MrCybernetic/MoistureSensorV2/README.md

# MoistureSensorV2

## Introduction
Moisture sensor sending values (battery voltage, moisture and temperature values) over MQTT. The MQTT are managed by Nodered to format and send via FTP to a [website](http://cybergarden.xyz/chart.html) to display them. The moisture soil sensor can be found with "Moisture Soil V1.2" keywords on internet. It's a capacitive sensor I prefer compare to resistive sensor (not reliable, corrosion).

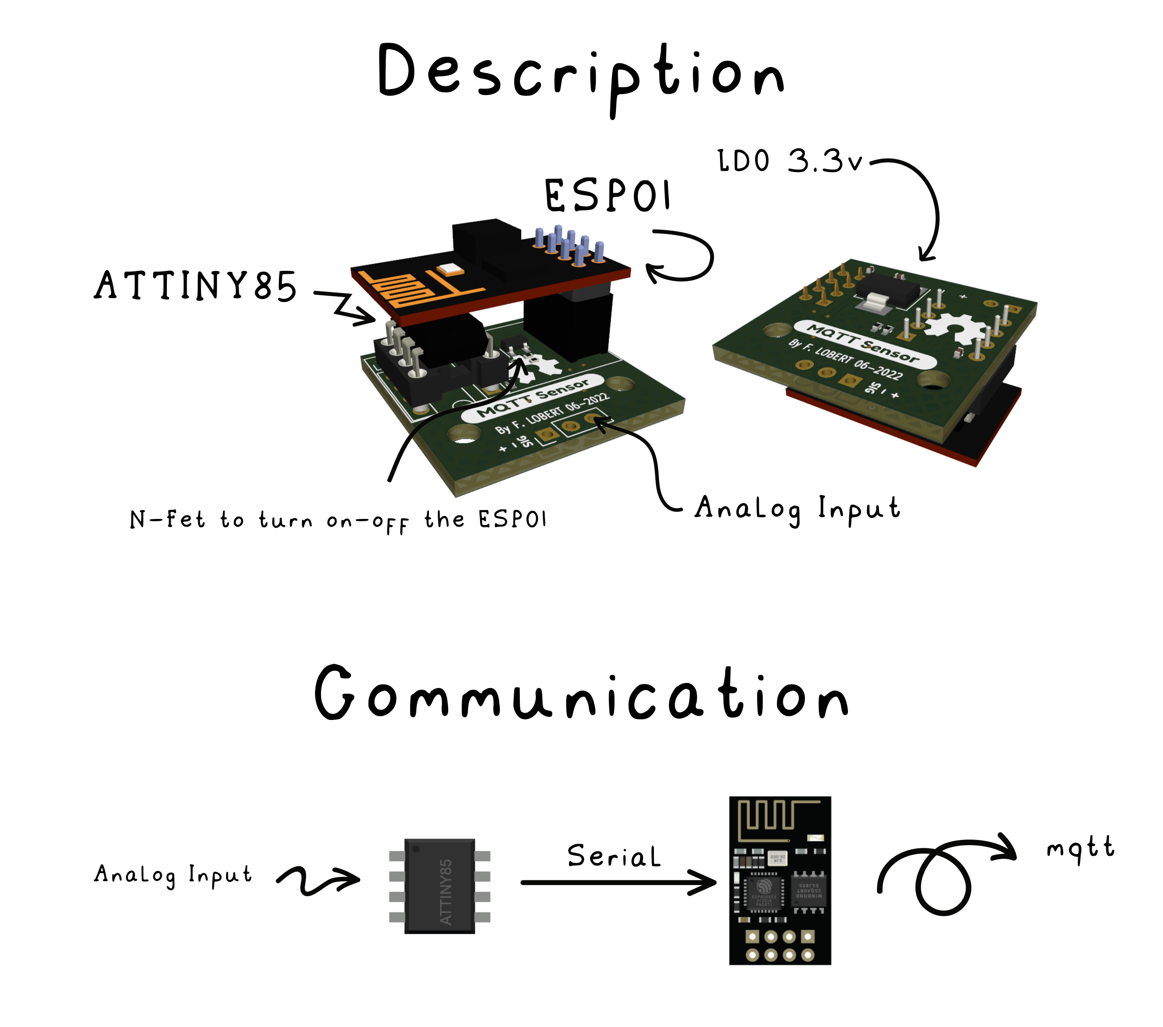
[picture p1: img/explanation.png]


## Status

 - Electronics ✅
 - CAD ✅
 - Developpment ✅
 - Tests ✅

## Challenges
- MQTT
- Power Consumption
- Data visualisation
- Components Shortage
- Outdoor stuff -> Waterproof
- Hobby stuff: 3D print, hand soldering

## CAO :
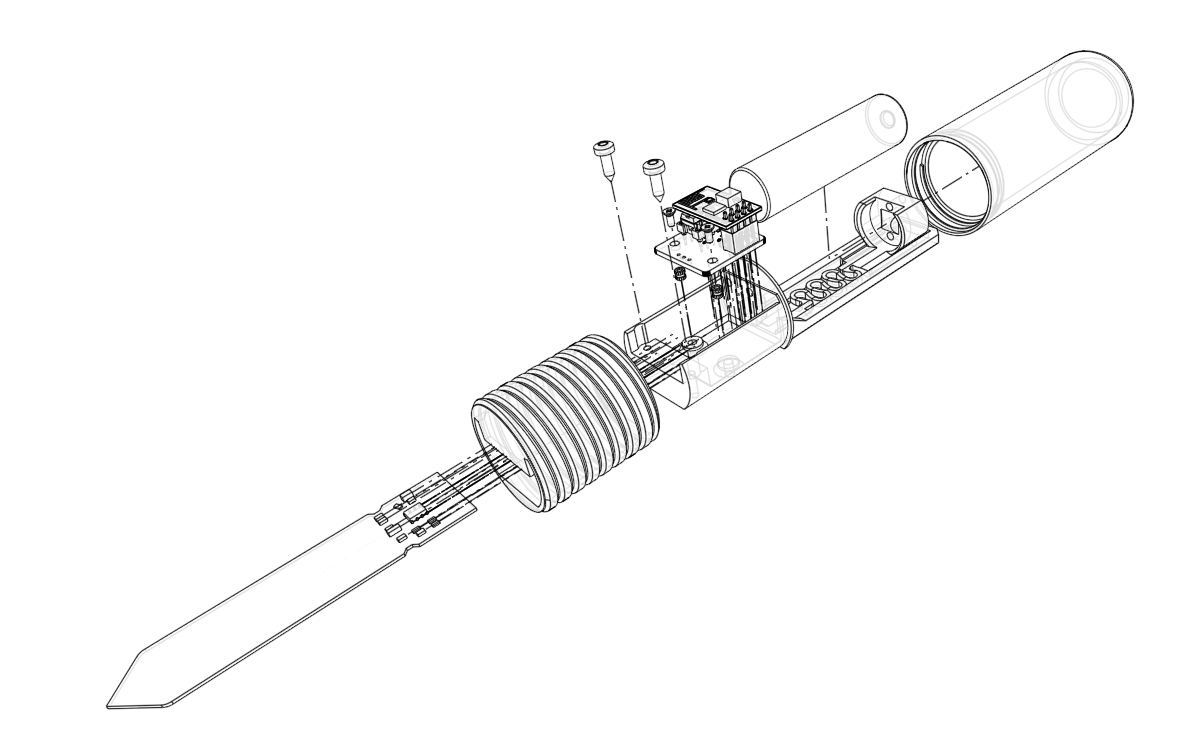
[picture p2: img/CAO.png]
