MrCybernetic/MoistureSensorV2/3Ds/OnShape_Link.txt

https://cad.onshape.com/documents/f10877bfe9b4fd1742ca4c39/w/fbb57eb4642451b069fcb2c7/e/eff2d412964ae911dceb8f07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
