MrCybernetic/MoistureSensorV2/img/IMG_2979.jpg

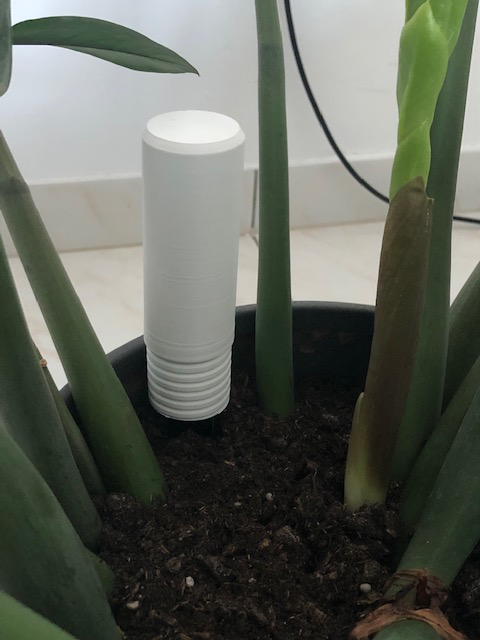
img/IMG_2979.jpg
