MrCybernetic/MoistureSensorV2/Electronics/circuit_diagram_MoistureSensorV2.pdf

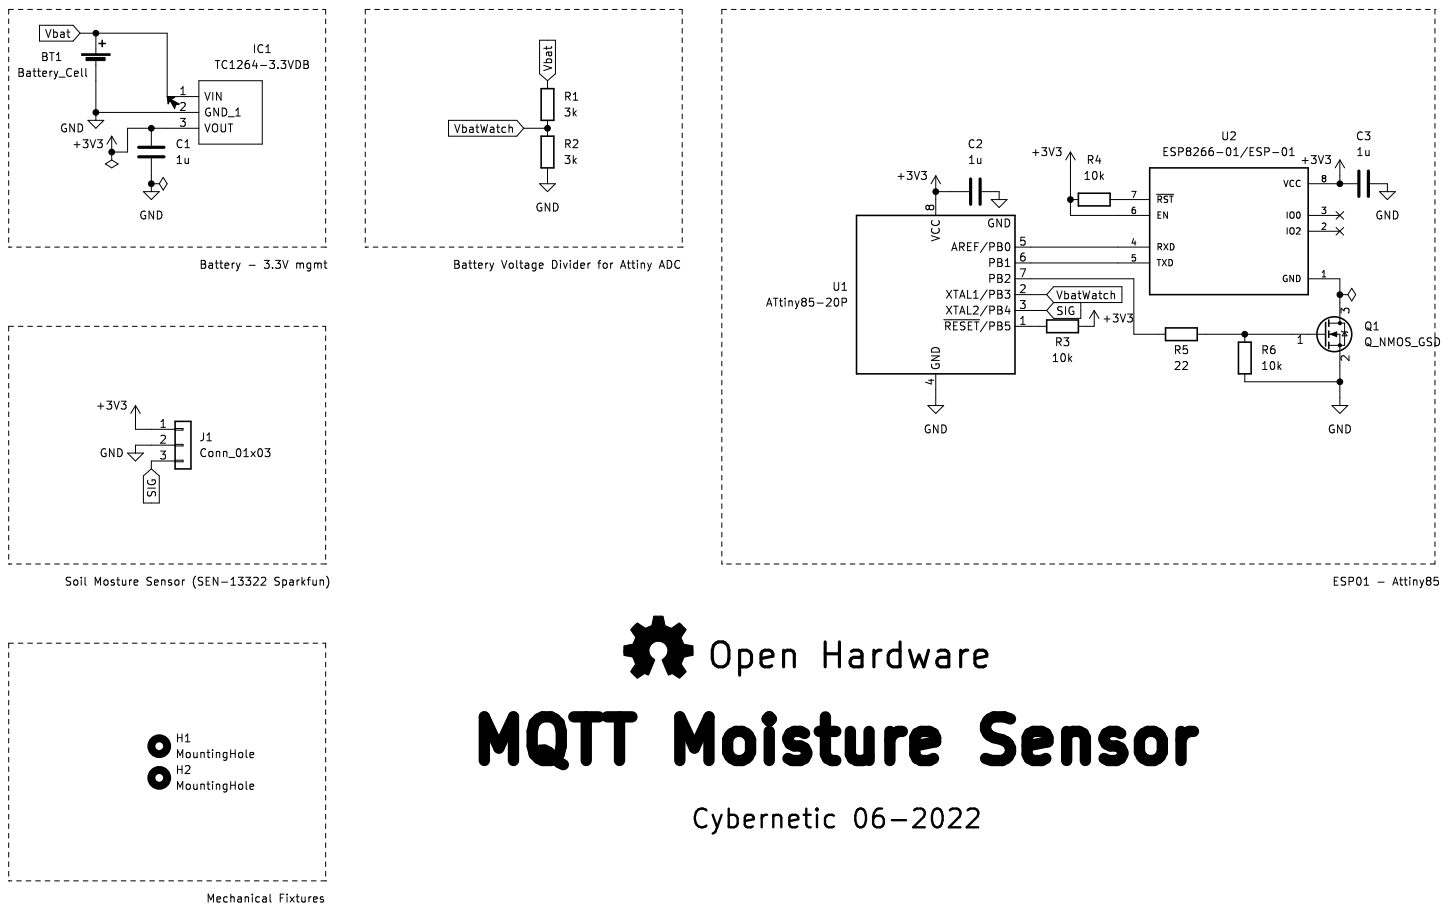
[picture p4: page 1]
