MrCybernetic/MoistureSensorV2/img/Attiny85_tuning_breadboard.png

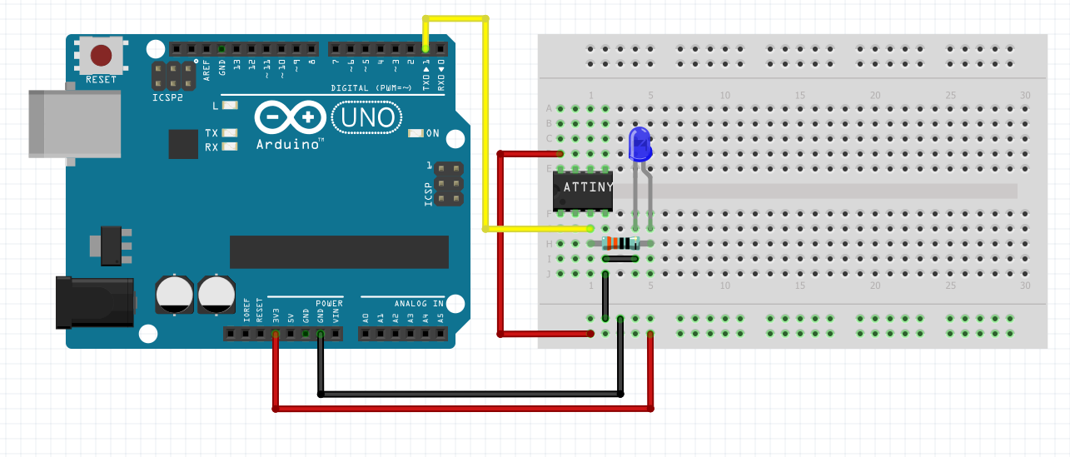
img/Attiny85_tuning_breadboard.png
