MrCybernetic/MoistureSensorV2/(commit log)

2022-06-26 string to char length fix
    [MoistureMQTT_ESP.ino]
2022-06-26 Header to define what the arduino sketch does
2022-06-26 Voltage for Attiny ADC error. Add voltage divider
2022-06-26 Correction in schematics and progress on arduinos
    [Attiny85Tuning.ino, MoistureMQTT_Attiny.ino]
2022-06-26 bom updated
2022-07-29 create sketch to test sensor
2022-08-03 Temperature integration (#2)
    * Modify code to run tests quickly
    * create sketch to test sensor
    * get initial code
    * integratin failed - Serial not working properly
    * Serial improvements
    * deleted unnecessary ino sketch
    * Improve Serial Com
    * fix issue for wake up
    [Attiny85Tuning.ino, MoistureMQTT_Attiny.ino, MoistureMQTT_ESP.ino]
2022-08-06 Add images and setup for sensor 2
